dwzg/probe-wink/enclosure/models/housing-lid.step

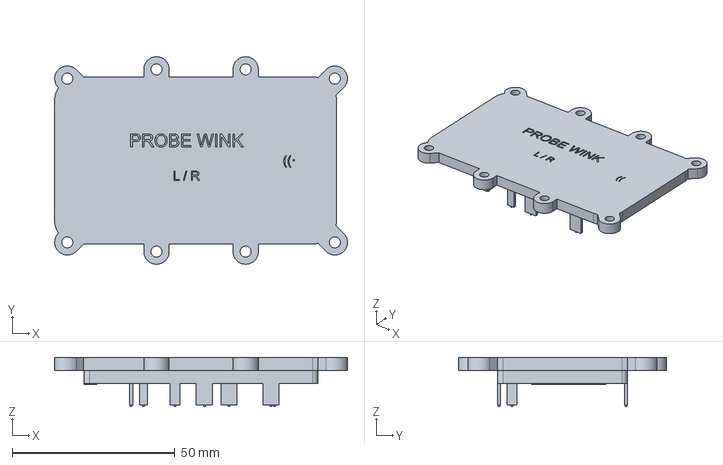
[picture p3: CAD file, 2026-11-01]
enclosure/models/housing-lid.step
90.0 x 63.8 x 15.2 mm
