dwzg/probe-wink/enclosure/models/housing-base.step

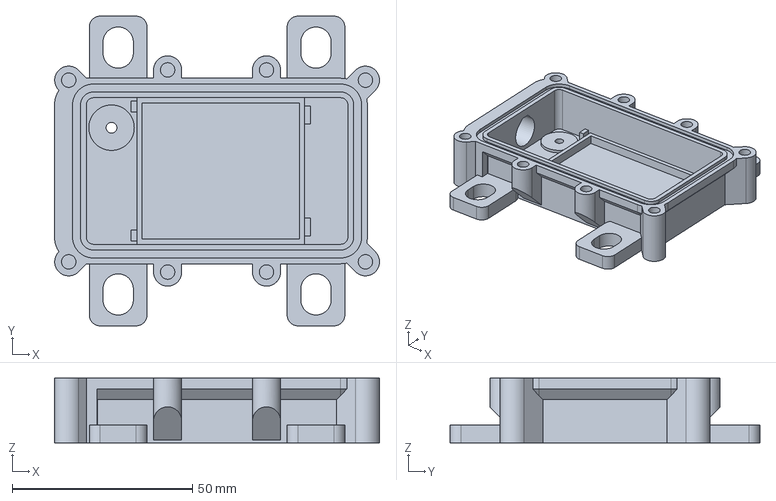
[picture p4: CAD file, 2026-11-01]
enclosure/models/housing-base.step
90.0 x 85.8 x 18.0 mm
