dwzg/probe-wink/(list of files, cad)

Other CAD files:
enclosure/models/housing-base.stl
enclosure/models/housing-lid.stl
