dwzg/probe-wink/pcb/probe-wink.kicad_pcb

## KiCad design pcb/probe-wink.kicad_pcb (2026-11-01)

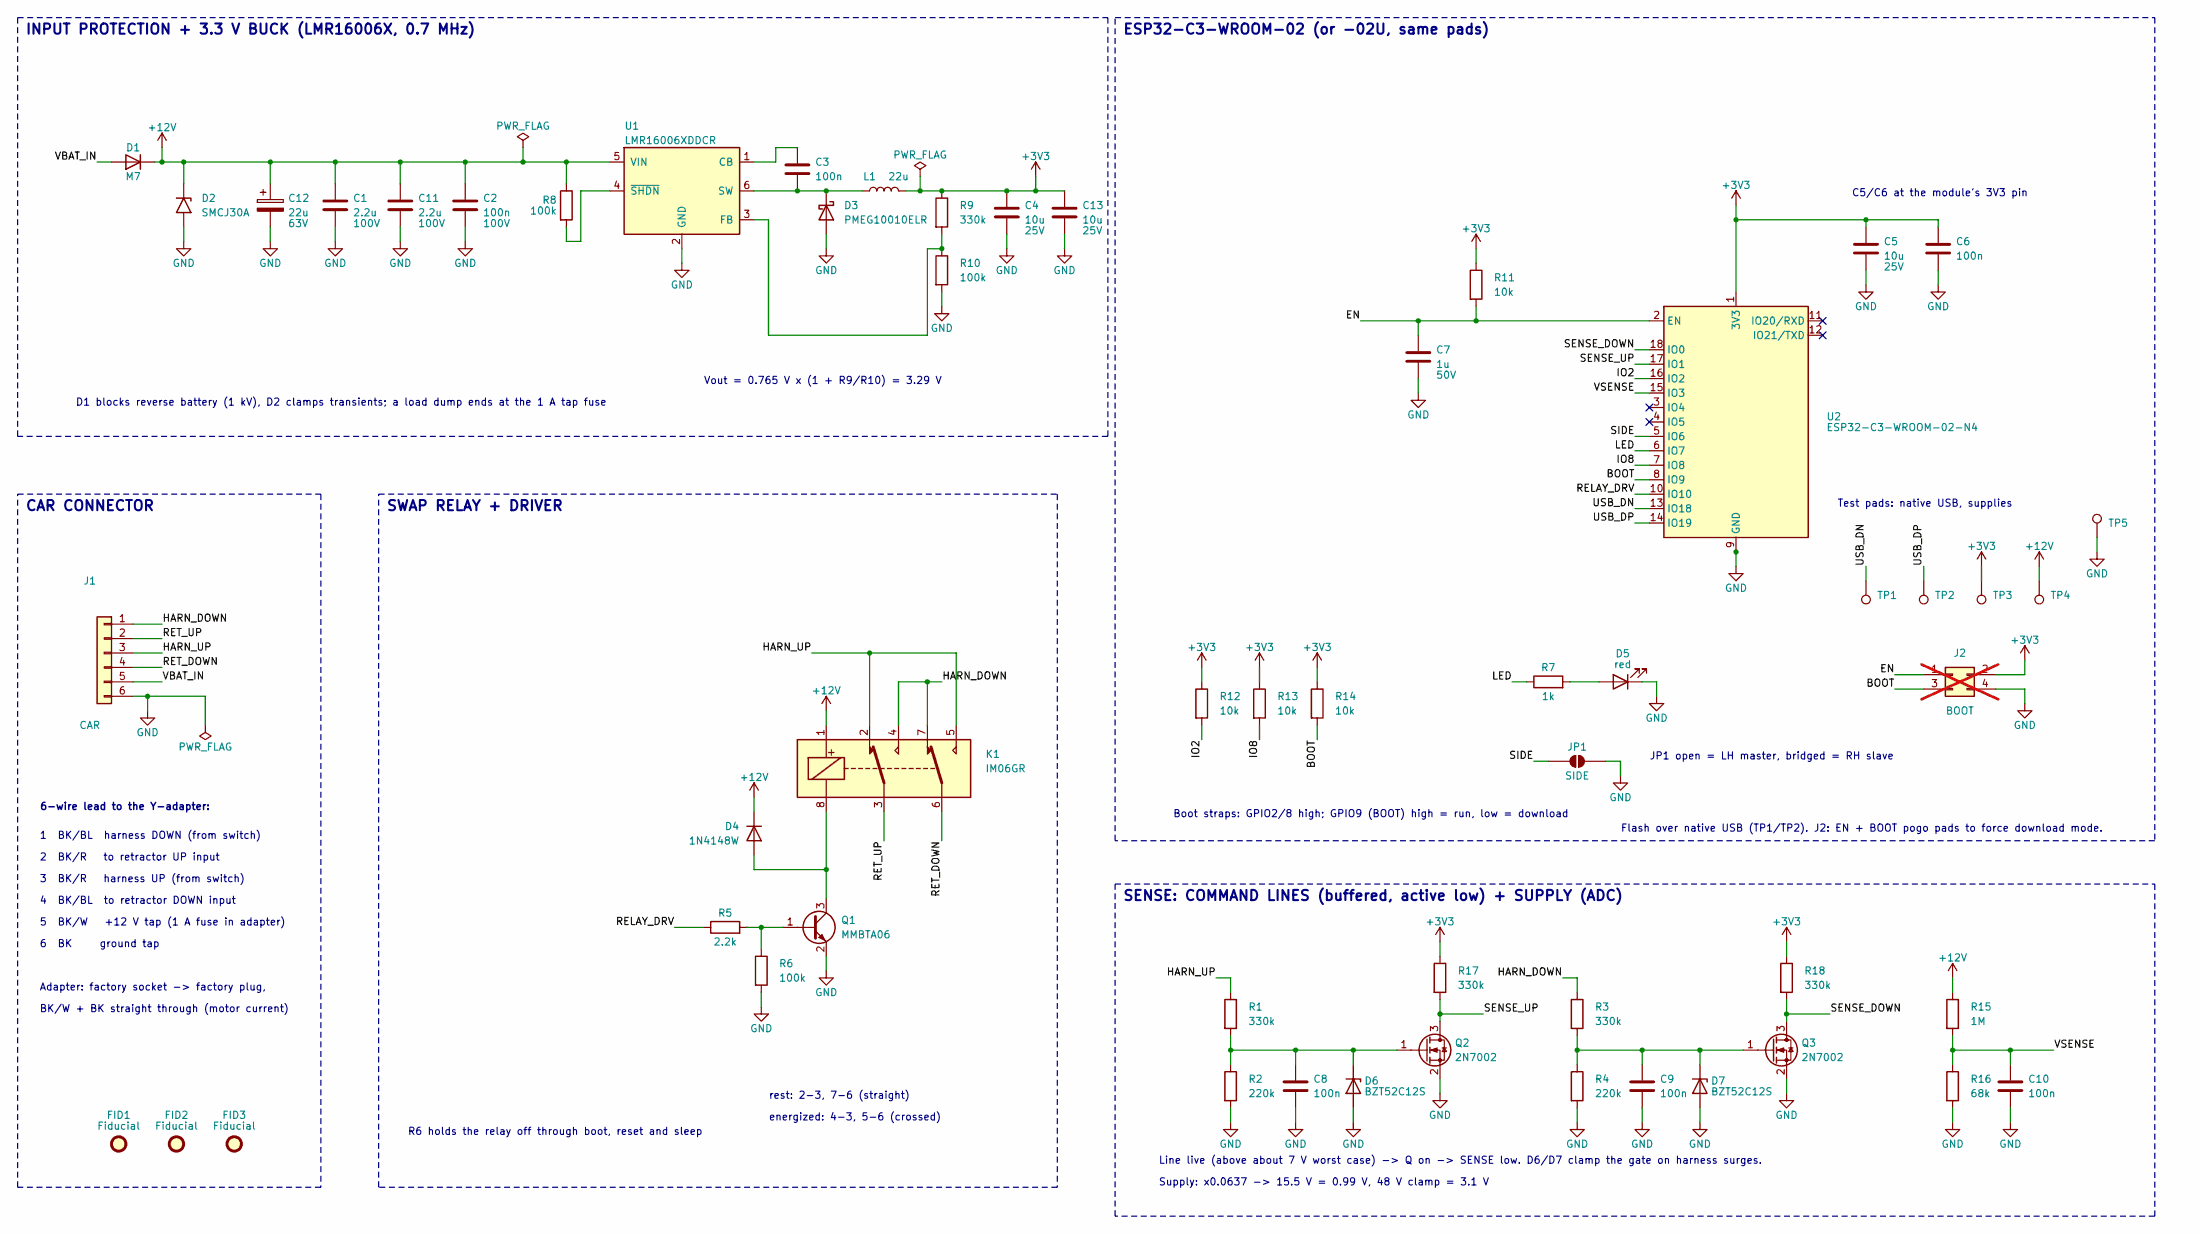
[picture p6: schematic probe-wink.kicad_sch, Probe wink module]

Parts:
C1, C11: 2.2u; C_1206_3216Metric; Rating 100V; MPN CC1206KKX7R0BB225; LCSC C577211
C2: 100n; C_0805_2012Metric; Rating 100V; MPN CL21B104KCFNNNE; LCSC C28233
C3, C6, C8, C9, C10: 100n; C_0805_2012Metric; MPN CC0805KRX7R9BB104; LCSC C49678
C4, C5, C13: 10u; C_0805_2012Metric; Rating 25V; MPN CL21B106KAYQNNE; LCSC C3039694
C7: 1u; C_0805_2012Metric; Rating 50V; MPN CL21B105KBFNNNE; LCSC C28323
C12: 22u; CP_Elec_6.3x5.4; Rating 63V; MPN RVT63V22M6X5; LCSC C51018397
D1: M7; D_SMA; MPN M7; LCSC C95872
D2: SMCJ30A; D_SMC; MPN SMCJ30A (Littelfuse); LCSC C224048
D3: PMEG10010ELR; Nexperia_CFP3_SOD-123W; MPN PMEG10010ELRX; LCSC C179426
D4: 1N4148W; D_SOD-123; MPN 1N4148W; LCSC C81598
D5: red; LED_0805_2012Metric; MPN NCD0805R1; LCSC C84256
D6, D7: BZT52C12S; D_SOD-323; MPN BZT52C12S; LCSC C14643
FID1, FID2, FID3: Fiducial; Fiducial_1mm_Mask2mm
J1: CAR; SolderWire-0.5sqmm_1x06_P4.8mm_D0.9mm_OD2.3mm; MPN sheathed 6 x 0.5 mm2 lead (LiYY 6x0.5)
J2: BOOT; PogoPads_2x02_P2.54mm; MPN bare pads on the back behind the module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; not fitted
JP1: SIDE; SolderJumper-2_P1.3mm_Open_RoundedPad1.0x1.5mm
K1: IM06GR; Relay_2P2T_10x6mm_TE_IMxxG; MPN IM06GR (TE), alt HFD4/12-SR C44212; LCSC C2153106
L1: 22u; L_Sunlord_SWPA5040S; MPN SWPA5040S220MT; LCSC C68434
Q1: MMBTA06; SOT-23; MPN MMBTA06LT1G (80 V NPN); LCSC C77760
Q2, Q3: 2N7002; SOT-23; MPN 2N7002; LCSC C8545
R1, R3, R9, R17, R18: 330k; R_0805_2012Metric; MPN 0805W8F3303T5E; LCSC C17629
R2, R4: 220k; R_0805_2012Metric; MPN 0805W8F2203T5E; LCSC C17556
R5: 2.2k; R_0805_2012Metric; MPN 0805W8F2201T5E; LCSC C17520
R6, R8, R10: 100k; R_0805_2012Metric; MPN 0805W8F1003T5E; LCSC C149504
R7: 1k; R_0805_2012Metric; MPN 0805W8F1001T5E; LCSC C17513
R11, R12, R13, R14: 10k; R_0805_2012Metric; MPN 0805W8F1002T5E; LCSC C17414
R15: 1M; R_0805_2012Metric; MPN 0805W8F1004T5E; LCSC C17514
R16: 68k; R_0805_2012Metric; MPN 0805W8F6802T5E; LCSC C17801
TP1: USB_DN; TestPoint_Pad_D1.5mm
TP2: USB_DP; TestPoint_Pad_D1.5mm
TP3: +3V3; TestPoint_Pad_D1.5mm
TP4: +12V; TestPoint_Pad_D1.5mm
TP5: GND; TestPoint_Pad_D1.5mm
U1: LMR16006XDDCR; TSOT-23-6; MPN LMR16006XDDCR; LCSC C87080
U2: ESP32-C3-WROOM-02-N4; ESP32-C3-WROOM-02; MPN ESP32-C3-WROOM-02-N4; LCSC C2934560

Connections:
+3V3: C4.1, C5.1, C6.1, C13.1, J2.2, L1.2, R9.1, R11.1, R12.1, R13.1, R14.1, R17.1, R18.1, TP3.1, U2.1 (3V3)
+12V: C1.1, C2.1, C11.1, C12.1, D1.1 (K), D2.1 (A1), D4.1 (K), K1.1, R8.1, R15.1, TP4.1, U1.5 (VIN)
/BOOT: J2.3, R14.2, U2.8 (IO9)
/EN: C7.1, J2.1, R11.2, U2.2 (EN)
/HARN_DOWN: J1.1, K1.4, K1.7, R3.1
/HARN_UP: J1.3, K1.2, K1.5, R1.1
/IO2: R12.2, U2.16 (IO2)
/IO8: R13.2, U2.7 (IO8)
/LED: R7.1, U2.6 (IO7)
/RELAY_DRV: R5.1, U2.10 (IO10)
/RET_DOWN: J1.4, K1.6
/RET_UP: J1.2, K1.3
/SENSE_DOWN: Q3.3 (D), R18.2, U2.18 (IO0)
/SENSE_UP: Q2.3 (D), R17.2, U2.17 (IO1)
/SIDE: JP1.1 (A), U2.5 (IO6)
/USB_DN: TP1.1, U2.13 (IO18)
/USB_DP: TP2.1, U2.14 (IO19)
/VBAT_IN: D1.2 (A), J1.5
/VSENSE: C10.1, R15.2, R16.1, U2.15 (IO3)
GND: C1.2, C2.2, C4.2, C5.2, C6.2, C7.2, C8.2, C9.2, C10.2, C11.2, C12.2, C13.2, D2.2 (A2), D3.2 (A), D5.1 (K), D6.2 (A), D7.2 (A), J1.6, J2.4, JP1.2 (B), Q1.2 (E), Q2.2 (S), Q3.2 (S), R2.2, R4.2, R6.2, R10.2, R16.2, TP5.1, U1.2 (GND), U2.9 (GND), U2.19 (GND)
unnamed: C3.2, D3.1 (K), L1.1, U1.6 (SW)
unnamed: D4.2 (A), K1.8, Q1.3 (C)
unnamed: D5.2 (A), R7.2
unnamed: C8.1, D6.1 (K), Q2.1 (G), R1.2, R2.1
unnamed: C9.1, D7.1 (K), Q3.1 (G), R3.2, R4.1
unnamed: Q1.1 (B), R5.2, R6.1
unnamed: C3.1, U1.1 (CB)
unnamed: R9.2, R10.1, U1.3 (FB)
unnamed: R8.2, U1.4 (~SHDN)

Notes on the sheet:
INPUT PROTECTION + 3.3 V BUCK (LMR16006X, 0.7 MHz)
Vout = 0.765 V x (1 + R9/R10) = 3.29 V
D1 blocks reverse battery (1 kV), D2 clamps transients; a load dump ends at the 1 A tap fuse
CAR CONNECTOR
6-wire lead to the Y-adapter:
1 BK/BL harness DOWN (from switch)
2 BK/R to retractor UP input
3 BK/R harness UP (from switch)
4 BK/BL to retractor DOWN input
5 BK/W +12 V tap (1 A fuse in adapter)
6 BK ground tap
Adapter: factory socket -> factory plug,
BK/W + BK straight through (motor current)
SWAP RELAY + DRIVER
rest: 2-3, 7-6 (straight)
energized: 4-3, 5-6 (crossed)
R6 holds the relay off through boot, reset and sleep
ESP32-C3-WROOM-02 (or -02U, same pads)
C5/C6 at the module's 3V3 pin
Boot straps: GPIO2/8 high; GPIO9 (BOOT) high = run, low = download
JP1 open = LH master, bridged = RH slave
Test pads: native USB, supplies
Flash over native USB (TP1/TP2). J2: EN + BOOT pogo pads to force download mode.
SENSE: COMMAND LINES (buffered, active low) + SUPPLY (ADC)
Line live (above about 7 V worst case) -> Q on -> SENSE low. D6/D7 clamp the gate on harness surges.
Supply: x0.0637 -> 15.5 V = 0.99 V, 48 V clamp = 3.1 V

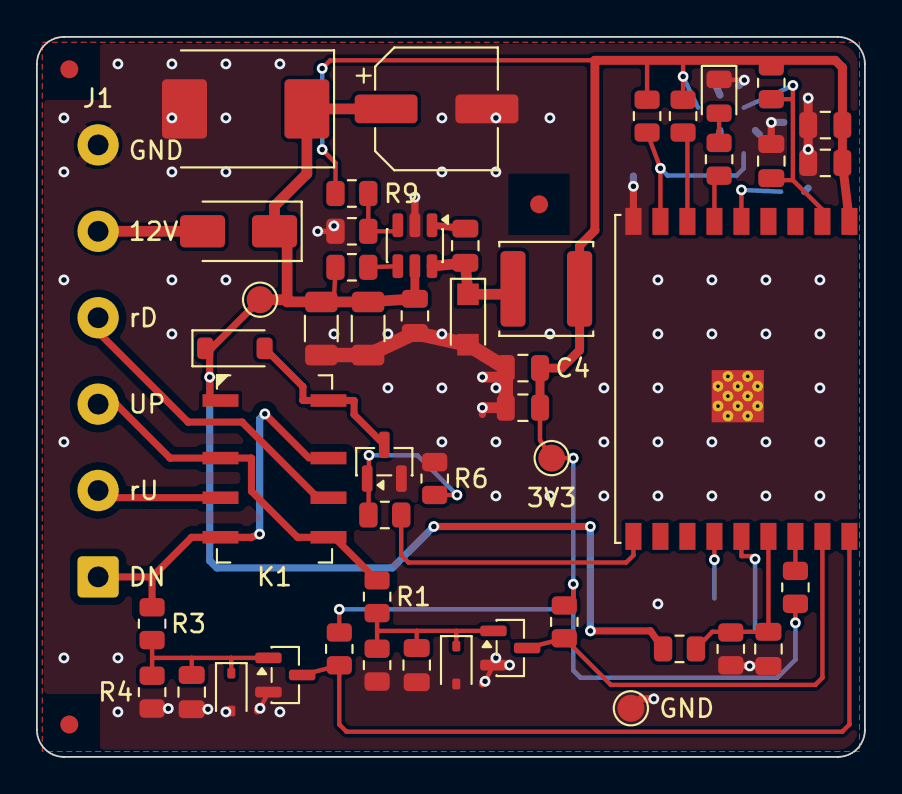
[picture p7: board probe-wink.kicad_pcb from above]

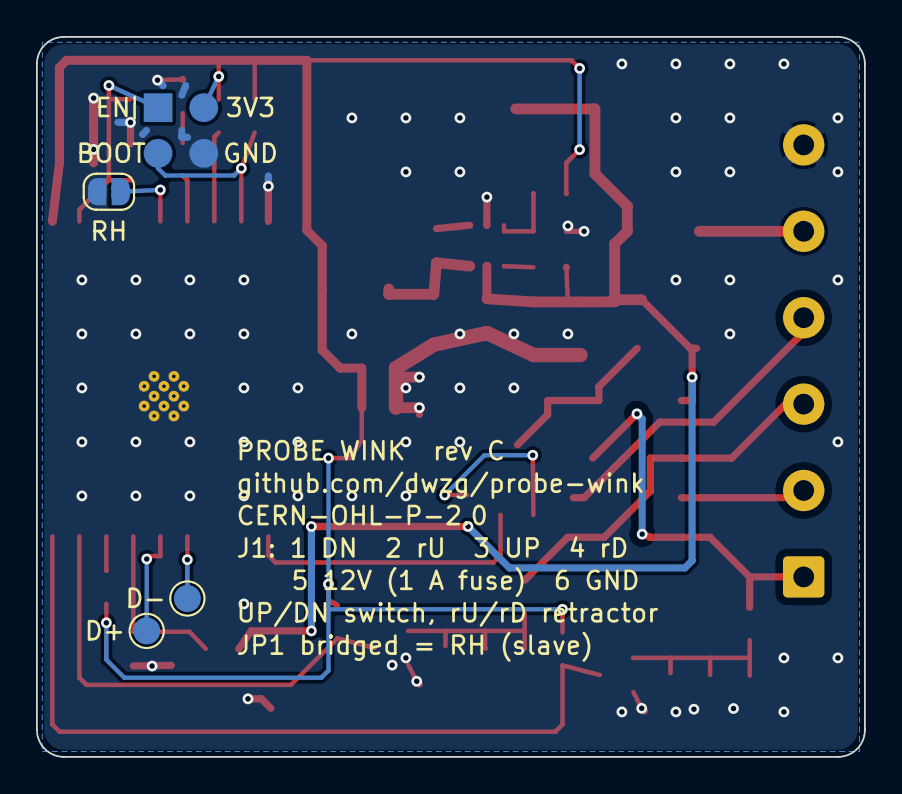
[picture p8: board probe-wink.kicad_pcb from below]

Board: 2 copper layers, 46.0 x 40.0 mm, 56 parts (4 on the bottom side), 29 nets.
