dwzg/probe-wink/pcb/schematic.py

#!/usr/bin/env python3
"""Probe wink module: schematic source.

Run:  python3 schematic.py   -> probe-wink.kicad_sch, intended_netlist.json, lib tables
The .kicad_sch is generated; edit this file, not the schematic.

Every part declares its nets; the drawing below realizes them with wires,
power symbols and labels. check.py proves KiCad sees the same nets.
"""
import json
import os
import sys

HERE = os.path.dirname(os.path.abspath(__file__))
sys.path.insert(0, os.path.join(HERE, "..", "tools", "hw-design", "src"))
from hwdesign.kicad.schematic import Schematic  # noqa: E402

R0805 = "Resistor_SMD:R_0805_2012Metric"
C0805 = "Capacitor_SMD:C_0805_2012Metric"
C1206 = "Capacitor_SMD:C_1206_3216Metric"
HAND = {"Assembly": "hand"}

# JLCPCB/LCSC numbers, verified in stock 2026-11-01. value -> (LCSC, MPN)
PASSIVES = {
    "330k": ("C17629", "0805W8F3303T5E"), "100k": ("C149504", "0805W8F1003T5E"),
    "30k": ("C17621", "0805W8F3002T5E"), "10k": ("C17414", "0805W8F1002T5E"),
    "1k": ("C17513", "0805W8F1001T5E"), "100": ("C17408", "0805W8F1000T5E"),
    "4.7u 50V": ("C29823", "1206B475K500NT"), "100n 50V": ("C49678", "CC0805KRX7R9BB104"),
    "100n": ("C49678", "CC0805KRX7R9BB104"), "22u 25V": ("C45783", "CL21A226MAQNNNE"),
    "10u 25V": ("C3039694", "CL21B106KAYQNNE"), "1u 50V": ("C28323", "CL21B105KBFNNNE"),
    "4.7k": ("C17673", "0805W8F4701T5E"), "2.2k": ("C17520", "0805W8F2201T5E"),
    "100n 100V": ("C28233", "CL21B104KCFNNNE"), "2.2u 100V": ("C577211", "CC1206KKX7R0BB225"),
    "1M": ("C17514", "0805W8F1004T5E"), "68k": ("C17801", "0805W8F6802T5E"),
    "220k": ("C17556", "0805W8F2203T5E"), "499": ("C17722", "0805W8F4990T5E"),
}


def part(lcsc, mpn, **extra):
    return {"Assembly": "SMT", "LCSC": lcsc, "MPN": mpn, **extra}


s = Schematic("probe-wink", title="Probe wink module", rev="C", date="2026-11-01",
              company="wtzg.de",
              comments=["One module per pop-up headlamp, 1989-92 Ford Probe",
                        "Swaps the retractor's UP/DOWN command lines; relay off = stock behavior",
                        "Generated by pcb/schematic.py - do not edit by hand",
                        "CERN-OHL-P-2.0 - source: github.com/dwzg/probe-wink"])

V_TXT = dict(ref_at=(3.05, -1.27), val_at=(3.05, 1.27))                  # vertical 2-pin parts
H_TXT = dict(ref_at=(0, -2.54, "center"), val_at=(0, 2.54, "center"))    # horizontal 2-pin parts


def R(ref, pos, value, a, b, rot=0, **f):
    txt = V_TXT if rot in (0, 180) else H_TXT
    return s.add(ref, "Device:R", pos, value, R0805, {"1": a, "2": b}, rot=rot,
                 fields=part(*PASSIVES[value], **f), **txt)


def C(ref, pos, value, a, b, fp=C0805, rot=0, **f):
    """Capacitor; a value like "2.2u 100V" shows the rating as its own line under the value."""
    txt = V_TXT if rot in (0, 180) else H_TXT
    cap, _, rating = value.partition(" ")
    fields = part(*PASSIVES[value], **f)
    show = None
    if rating:
        fields["Rating"] = rating
        show = ["Rating"]
    return s.add(ref, "Device:C", pos, cap, fp, {"1": a, "2": b}, rot=rot, fields=fields, show=show, **txt)


def gnd(at):
    s.power("GND", at)


# ============================================================ power input + buck
s.frame(20.32, 20.32, 191.77, 73.66, "INPUT PROTECTION + 3.3 V BUCK (LMR16006X, 0.7 MHz)")
s.add("U1", "Regulator_Switching:LMR16006YQ", (137.16, 50.8), "LMR16006XDDCR",
      "Package_TO_SOT_SMD:TSOT-23-6",
      {"1": "BUCK_CB", "2": "GND", "3": "BUCK_FB", "4": "BUCK_EN", "5": "+12V", "6": "BUCK_SW"},
      fields=part("C87080", "LMR16006XDDCR"))
rail = s.pin("U1", 5)[1]                       # +12 V rail runs at VIN height
s.add("D1", "Device:D", (40.64, rail), "M7", "Diode_SMD:D_SMA",
      {"1": "+12V", "2": "VBAT_IN"}, rot=180,
      fields=part("C95872", "M7", Function="reverse polarity, 1 kV"), **H_TXT)
s.tag(("D1", 2))                               # VBAT_IN from the car connector
s.add("D2", "Diode:SM6T24A", (49.53, rail + 7.62), "SMCJ30A", "Diode_SMD:D_SMC",
      {"1": "+12V", "2": "GND"}, rot=270, fields=part("C224048", "SMCJ30A (Littelfuse)"), **V_TXT)
s.add("C12", "Device:C_Polarized", (64.77, rail + 7.62), "22u", "Capacitor_SMD:CP_Elec_6.3x5.4",
      {"1": "+12V", "2": "GND"}, fields=part("C51018397", "RVT63V22M6X5", Function="bulk, damping", Rating="63V"),
      show=["Rating"],
      **V_TXT)
C("C1", (76.2, rail + 7.62), "2.2u 100V", "+12V", "GND", fp=C1206)
C("C11", (87.63, rail + 7.62), "2.2u 100V", "+12V", "GND", fp=C1206)
C("C2", (99.06, rail + 7.62), "100n 100V", "+12V", "GND")
R("R8", (116.84, rail + 7.62), "100k", "+12V", "BUCK_EN")
s.wire(("D1", 1), ("U1", 5))                   # the rail
for ref in ("D2", "C12", "C1", "C11", "C2", "R8"):
    s.wire((ref, 1), (s.pin(ref, 1)[0], rail))
for ref in ("D2", "C12", "C1", "C11", "C2"):
    gnd((ref, 2))
x_en = s.pin("U1", 4)[0] - 5.08
r8b = s.pin("R8", 2)
s.wire(("R8", 2), (r8b[0], r8b[1] + 2.54), (x_en, r8b[1] + 2.54), (x_en, s.pin("U1", 4)[1]), ("U1", 4))
s.power("+12V", (45.72, rail), direction="up")
s.power_flag("+12V", (109.22, rail))
gnd(("U1", 2))
# boot cap, catch diode, inductor along the switch node
cb, sw, fb = s.pin("U1", 1), s.pin("U1", 6), s.pin("U1", 3)
C("C3", (cb[0] + 7.62, sw[1] - 3.81), "100n", "BUCK_CB", "BUCK_SW")
s.wire(("U1", 1), (cb[0] + 3.81, cb[1]), (cb[0] + 3.81, s.pin("C3", 1)[1]), ("C3", 1))
s.add("D3", "Device:D_Schottky", (cb[0] + 12.7, sw[1] + 3.81), "PMEG10010ELR", "Diode_SMD:Nexperia_CFP3_SOD-123W",
      {"1": "BUCK_SW", "2": "GND"}, rot=270,
      fields=part("C179426", "PMEG10010ELRX", Function="catch diode, low leakage hot"), **V_TXT)
s.add("L1", "Device:L", (cb[0] + 22.86, sw[1]), "22u", "Inductor_SMD:L_Sunlord_SWPA5040S",
      {"1": "BUCK_SW", "2": "+3V3"}, rot=90, fields=part("C68434", "SWPA5040S220MT"),
      ref_at=(-2.54, -2.54, "center"), val_at=(2.54, -2.54, "center"))
s.wire(("U1", 6), ("C3", 2))
s.wire(("C3", 2), ("D3", 1))
s.wire(("D3", 1), ("L1", 1))
gnd(("D3", 2))
# output: divider + output cap + 3V3 symbol
xo = s.pin("L1", 2)[0]
R("R9", (xo + 6.35, sw[1] + 3.81), "330k", "+3V3", "BUCK_FB")
R("R10", (xo + 6.35, sw[1] + 13.97), "100k", "BUCK_FB", "GND")
C("C4", (xo + 17.78, sw[1] + 3.81), "10u 25V", "+3V3", "GND")
C("C13", (xo + 27.94, sw[1] + 3.81), "10u 25V", "+3V3", "GND")
s.wire(("L1", 2), ("R9", 1))
s.wire(("R9", 1), ("C4", 1))
s.wire(("C4", 1), ("C13", 1))
s.power("+3V3", (xo + 22.86, sw[1]), direction="up")
s.power_flag("+3V3", (xo + 2.54, sw[1]))
s.wire(("R9", 2), ("R10", 1))
gnd(("R10", 2))
gnd(("C4", 2))
gnd(("C13", 2))
r9b = s.pin("R9", 2)
y_fb = s.pin("R10", 2)[1] + 7.62
s.wire(("U1", 3), (fb[0] + 2.54, fb[1]), (fb[0] + 2.54, y_fb), (xo + 3.81, y_fb),
       (xo + 3.81, r9b[1] + 1.905), (r9b[0], r9b[1] + 1.905))
s.text("Vout = 0.765 V x (1 + R9/R10) = 3.29 V", 140.97, 85.09)
s.text("D1 blocks reverse battery (1 kV), D2 clamps transients; a load dump ends at the 1 A tap fuse", 30.48, 88.9)

# ============================================================ car connector
s.frame(20.32, 104.14, 53.34, 121.92, "CAR CONNECTOR")
s.add("J1", "Connector_Generic:Conn_01x06", (35.56, 132.08), "CAR",
      "Connector_Wire:SolderWire-0.5sqmm_1x06_P4.8mm_D0.9mm_OD2.3mm",
      {"1": "HARN_DOWN", "2": "RET_UP", "3": "HARN_UP", "4": "RET_DOWN", "5": "VBAT_IN", "6": "GND"},
      mirror=True, fields={**HAND, "MPN": "sheathed 6 x 0.5 mm2 lead (LiYY 6x0.5)"},
      ref_at=(-2.54, -12.7, "center"), val_at=(-2.54, 12.7, "center"))
for n in (1, 2, 3, 4, 5):
    s.tag(("J1", n), length=5.08)
j6 = s.pin("J1", 6)
s.wire(("J1", 6), (j6[0] + 2.54, j6[1]))
s.power("GND", (j6[0] + 2.54, j6[1]), direction="down")
s.wire((j6[0] + 2.54, j6[1]), (j6[0] + 12.7, j6[1]))
s.power_flag("GND", (j6[0] + 12.7, j6[1]), direction="down", length=5.08)
s.text("6-wire lead to the Y-adapter:", 24.13, 160.02, size=1.27, bold=True)
for i, line in enumerate(["1  BK/BL  harness DOWN (from switch)",
                          "2  BK/R   to retractor UP input",
                          "3  BK/R   harness UP (from switch)",
                          "4  BK/BL  to retractor DOWN input",
                          "5  BK/W   +12 V tap (1 A fuse in adapter)",
                          "6  BK     ground tap"]):
    s.text(line, 24.13, 165.1 + i * 3.81, size=1.27)
s.text("Adapter: factory socket -> factory plug,", 24.13, 191.77, size=1.27)
s.text("BK/W + BK straight through (motor current)", 24.13, 195.58, size=1.27)

# ============================================================ swap relay + driver
s.frame(83.82, 104.14, 119.38, 121.92, "SWAP RELAY + DRIVER")
# TE IM06GR (alt. Hongfa HFD4/12-SR, same footprint): pin numbering as Omron G6K-2
s.add("K1", "Relay:G6K-2", (172.72, 152.4), "IM06GR", "Relay_SMD:Relay_2P2T_10x6mm_TE_IMxxG",
      {"1": "+12V", "8": "COIL_LO", "3": "RET_UP", "2": "HARN_UP", "4": "HARN_DOWN",
       "6": "RET_DOWN", "7": "HARN_DOWN", "5": "HARN_UP"},
      fields=part("C2153106", "IM06GR (TE), alt HFD4/12-SR C44212"),
      ref_at=(17.78, -2.54), val_at=(17.78, 0))
# map to the drawing names used below (G5V-2 numbering of rev A)
_m = {1: 1, 4: 3, 6: 2, 8: 4, 9: 5, 11: 7, 13: 6, 16: 8}
k = {n: s.pin("K1", _m[n]) for n in _m}
y_up, y_dn = k[6][1] - 12.7, k[6][1] - 7.62     # HARN_UP bus above HARN_DOWN bus
s.wire(("K1", 2), (k[6][0], y_up), (k[9][0], y_up), ("K1", 5))
s.wire(("K1", 4), (k[8][0], y_dn), (k[11][0], y_dn), ("K1", 7))
s.wire((k[6][0], y_up), (k[6][0] - 10.16, y_up))
s.tag((k[6][0] - 10.16, y_up), "HARN_UP", length=0, direction="left")
s.wire((k[11][0], y_dn), (k[11][0] + 2.54, y_dn))
s.tag((k[11][0] + 2.54, y_dn), "HARN_DOWN", length=0, direction="right")
s.tag(("K1", 3), length=5.08)
s.tag(("K1", 6), length=5.08)
s.power("+12V", ("K1", 1))
s.text("rest: 2-3, 7-6 (straight)", 152.4, 210.82)
s.text("energized: 4-3, 5-6 (crossed)", 152.4, 214.63)
# driver
s.add("Q1", "Transistor_BJT:MMBTA06", (k[16][0] - 2.54, k[16][1] + 20.32), "MMBTA06",
      "Package_TO_SOT_SMD:SOT-23", {"1": "RELAY_G", "2": "GND", "3": "COIL_LO"},
      fields=part("C77760", "MMBTA06LT1G (80 V NPN)"), ref_at=(5.08, -1.27), val_at=(5.08, 1.27))
s.wire(("K1", 8), ("Q1", 3))
gnd(("Q1", 2))
s.add("D4", "Device:D", (k[16][0] - 12.7, k[16][1] + 3.81), "1N4148W", "Diode_SMD:D_SOD-123",
      {"1": "+12V", "2": "COIL_LO"}, rot=270, fields=part("C81598", "1N4148W", Function="flyback"),
      ref_at=(-2.54, -1.27, "right"), val_at=(-2.54, 1.27, "right"))
s.power("+12V", ("D4", 1))
d4a = s.pin("D4", 2)
s.wire(("D4", 2), (d4a[0], d4a[1] + 2.54), (k[16][0], d4a[1] + 2.54))
g = s.pin("Q1", 1)
R("R5", (g[0] - 10.16, g[1]), "2.2k", "RELAY_DRV", "RELAY_G", rot=90)
s.wire(("R5", 2), ("Q1", 1))
R("R6", (g[0] - 3.81, g[1] + 7.62), "100k", "RELAY_G", "GND")
s.wire(("R6", 1), (g[0] - 3.81, g[1]))
gnd(("R6", 2))
s.tag(("R5", 1), length=5.08)
s.text("R6 holds the relay off through boot, reset and sleep", 88.9, 217.17)

# ============================================================ ESP32-C3
s.frame(213.36, 20.32, 182.88, 144.78, "ESP32-C3-WROOM-02 (or -02U, same pads)")
s.add("U2", "RF_Module:ESP32-C3-WROOM-02", (322.58, 91.44), "ESP32-C3-WROOM-02-N4",
      "RF_Module:ESP32-C3-WROOM-02",
      {"1": "+3V3", "2": "EN", "9": "GND", "19": "GND",
       "18": "SENSE_DOWN", "17": "SENSE_UP", "16": "IO2", "15": "VSENSE",
       "3": None, "4": None, "5": "SIDE", "6": "LED", "7": "IO8", "8": "BOOT",
       "10": "RELAY_DRV", "13": "USB_DN", "14": "USB_DP", "11": None, "12": None},
      fields=part("C2934560", "ESP32-C3-WROOM-02-N4"))
v3 = s.pin("U2", 1)
y3 = v3[1] - 12.7
C("C5", (v3[0] + 22.86, y3 + 5.08), "10u 25V", "+3V3", "GND")
C("C6", (v3[0] + 35.56, y3 + 5.08), "100n", "+3V3", "GND")
s.wire(("U2", 1), (v3[0], y3), (s.pin("C6", 1)[0], y3))
s.wire(("C5", 1), (s.pin("C5", 1)[0], y3))
s.wire(("C6", 1), (s.pin("C6", 1)[0], y3))
s.power("+3V3", (v3[0], y3), direction="up")
gnd(("C5", 2))
gnd(("C6", 2))
s.text("C5/C6 at the module's 3V3 pin", v3[0] + 20.32, y3 - 3.81)
gnd(("U2", 9))
s.drawn.add(("U2", "19"))   # second GND pin shares the symbol position with pin 9
# EN: pull-up, RC delay, reset button
en = s.pin("U2", 2)
xs = [en[0] - 30.48, en[0] - 40.64, en[0] - 50.8]   # R11, C7, SW2 columns
R("R11", (xs[0], en[1] - 6.35), "10k", "+3V3", "EN")
C("C7", (xs[1], en[1] + 6.35), "1u 50V", "EN", "GND")
s.wire(("U2", 2), (xs[2], en[1]))
s.wire(("R11", 2), (xs[0], en[1]))
s.wire(("C7", 1), (xs[1], en[1]))
s.tag((xs[2], en[1]), "EN", length=0, direction="left")
s.power("+3V3", ("R11", 1))
gnd(("C7", 2))
for n in (18, 17, 16, 15, 10, 5, 6, 7, 8, 13, 14):
    s.tag(("U2", n), length=2.54)
# strapping pins + boot button
y_s = 140.97
for i, (ref, net) in enumerate((("R12", "IO2"), ("R13", "IO8"), ("R14", "BOOT"))):
    x = 228.6 + i * 10.16
    R(ref, (x, y_s), "10k", "+3V3", net)
    s.power("+3V3", (ref, 1))
    s.tag((ref, 2), length=2.54)
s.text("Boot straps: GPIO2/8 high; GPIO9 (BOOT) high = run, low = download", 223.52, 161.29)
# LED + side jumper
R("R7", (289.56, y_s - 3.81), "1k", "LED", "LED_A", rot=90)
s.tag(("R7", 1), length=2.54)
s.add("D5", "Device:LED", (302.26, y_s - 3.81), "red", "LED_SMD:LED_0805_2012Metric",
      {"1": "GND", "2": "LED_A"}, rot=180, fields=part("C84256", "NCD0805R1"), **H_TXT)
s.wire(("R7", 2), ("D5", 2))
dk = s.pin("D5", 1)
s.wire(("D5", 1), (dk[0] + 2.54, dk[1]))
s.power("GND", (dk[0] + 2.54, dk[1]), direction="down")
s.add("JP1", "Jumper:SolderJumper_2_Open", (294.64, y_s + 10.16), "SIDE",
      "Jumper:SolderJumper-2_P1.3mm_Open_RoundedPad1.0x1.5mm",
      {"1": "SIDE", "2": "GND"}, fields={"Assembly": "none"}, **H_TXT)
s.tag(("JP1", 1), length=2.54)
jb = s.pin("JP1", 2)
s.wire(("JP1", 2), (jb[0] + 2.54, jb[1]))
s.power("GND", (jb[0] + 2.54, jb[1]), direction="down")
s.text("JP1 open = LH master, bridged = RH slave", 307.34, 151.13)
# programming header (ESP-Prog pinout) + test pads
s.add("J2", "Connector_Generic:Conn_02x02_Odd_Even", (360.68, 135.89), "BOOT",
      "probe-wink:PogoPads_2x02_P2.54mm",
      {"1": "EN", "2": "+3V3", "3": "BOOT", "4": "GND"},
      fields={"Assembly": "none", "MPN": "bare pads on the back behind the module: pogo clip"}, dnp=True,
      ref_at=(1.27, -3.81, "center"), val_at=(1.27, 6.35, "center"))
for n in (1, 3):
    s.tag(("J2", n), length=5.08)
j2p2, j2p4 = s.pin("J2", 2), s.pin("J2", 4)
s.wire(("J2", 2), (j2p2[0] + 5.08, j2p2[1]))
s.power("+3V3", (j2p2[0] + 5.08, j2p2[1]), direction="up")
s.wire(("J2", 4), (j2p4[0] + 5.08, j2p4[1]))
s.power("GND", (j2p4[0] + 5.08, j2p4[1]), direction="down")
for i, (ref, net) in enumerate((("TP1", "USB_DN"), ("TP2", "USB_DP"), ("TP3", "+3V3"), ("TP4", "+12V"))):
    x = 345.44 + i * 10.16
    s.add(ref, "Connector:TestPoint", (x, 119.38), net, "TestPoint:TestPoint_Pad_D1.5mm",
          {"1": net}, rot=180, fields={"Assembly": "none"}, in_bom=False,
          ref_at=(1.9, 2.54), val_at=(1.27, 6.35), hide_value=True)
    if net.startswith("+"):
        s.power(net, (ref, 1))
    else:
        s.tag((ref, 1), length=2.54)
s.add("TP5", "Connector:TestPoint", (386.08, 111.76), "GND", "TestPoint:TestPoint_Pad_D1.5mm",
      {"1": "GND"}, fields={"Assembly": "none"}, in_bom=False, ref_at=(1.9, -2.54), val_at=(1.27, 6.35),
      hide_value=True)
s.power("GND", ("TP5", 1))
s.text("Test pads: native USB, supplies", 340.36, 106.68)
s.text("Flash over native USB (TP1/TP2). J2: EN + BOOT pogo pads to force download mode.", 302.26, 163.83)

# ============================================================ sense buffers + supply divider
s.frame(213.36, 172.72, 182.88, 58.42, "SENSE: COMMAND LINES (buffered, active low) + SUPPLY (ADC)")
for (rt, rb, cc, dz, q, rp, line, g, out, x0) in (
        ("R1", "R2", "C8", "D6", "Q2", "R17", "HARN_UP", "UP_G", "SENSE_UP", 233.68),
        ("R3", "R4", "C9", "D7", "Q3", "R18", "HARN_DOWN", "DN_G", "SENSE_DOWN", 294.64)):
    R(rt, (x0, 195.58), "330k", line, g)
    R(rb, (x0, 208.28), "220k", g, "GND")
    C(cc, (x0 + 11.43, 208.28), "100n", g, "GND")
    s.add(dz, "Device:D_Zener", (x0 + 21.59, 208.28), "BZT52C12S", "Diode_SMD:D_SOD-323",
          {"1": g, "2": "GND"}, rot=270, fields=part("C14643", "BZT52C12S"), **V_TXT)
    s.add(q, "Transistor_FET:2N7002", (x0 + 34.29, 201.93), "2N7002", "Package_TO_SOT_SMD:SOT-23",
          {"1": g, "2": "GND", "3": out}, fields=part("C8545", "2N7002"), ref_at=(5.08, -1.27), val_at=(5.08, 1.27))
    R(rp, (x0 + 36.83, 189.23), "330k", "+3V3", out)
    node = (x0, 201.93)
    s.wire((rt, 2), node, (rb, 1))
    s.wire(node, (x0 + 11.43, node[1]), (x0 + 21.59, node[1]), (q, 1))
    s.wire((x0 + 11.43, node[1]), (cc, 1))
    s.wire((x0 + 21.59, node[1]), (dz, 1))
    s.wire((q, 3), (rp, 2))
    s.wire((x0 + 36.83, 195.58), (x0 + 44.45, 195.58))
    s.tag((x0 + 44.45, 195.58), out, length=0, direction="right")
    rt1 = s.pin(rt, 1)
    s.wire((rt, 1), (rt1[0], rt1[1] - 2.54), (rt1[0] - 2.54, rt1[1] - 2.54))
    s.tag((rt1[0] - 2.54, rt1[1] - 2.54), line, length=0, direction="left")
    s.power("+3V3", (rp, 1))
    for ref, pin in ((rb, 2), (cc, 2), (dz, 2), (q, 2)):
        gnd((ref, pin))
x0 = 360.68
R("R15", (x0, 195.58), "1M", "+12V", "VSENSE")
R("R16", (x0, 208.28), "68k", "VSENSE", "GND")
C("C10", (x0 + 10.16, 208.28), "100n", "VSENSE", "GND")
node = (x0, 201.93)
s.wire(("R15", 2), node, ("R16", 1))
s.wire(node, (x0 + 10.16, node[1]), ("C10", 1))
s.wire((x0 + 10.16, node[1]), (x0 + 17.78, node[1]))
s.tag((x0 + 17.78, node[1]), "VSENSE", length=0, direction="right")
s.power("+12V", ("R15", 1))
gnd(("R16", 2))
gnd(("C10", 2))
s.text("Line live (above about 7 V worst case) -> Q on -> SENSE low. D6/D7 clamp the gate on harness surges.", 220.98, 222.25)
s.text("Supply: x0.0637 -> 15.5 V = 0.99 V, 48 V clamp = 3.1 V", 220.98, 226.06)

# ============================================================ mechanical
for i in range(3):
    s.add("FID%d" % (i + 1), "Mechanical:Fiducial", (38.1 + i * 10.16, 218.44), "Fiducial",
          "Fiducial:Fiducial_1mm_Mask2mm", fields={"Assembly": "none"}, in_bom=False)

s.finish()
out = os.path.join(HERE, "probe-wink.kicad_sch")
s.save(out)
s.write_lib_tables(HERE)
pro = os.path.join(HERE, "probe-wink.kicad_pro")
if not os.path.exists(pro):
    with open(pro, "w") as f:
        json.dump({"meta": {"filename": "probe-wink.kicad_pro", "version": 1}}, f)
with open(os.path.join(HERE, "intended_netlist.json"), "w") as f:
    json.dump(s.netlist(), f, indent=1, sort_keys=True)
for w in s.warnings:
    print("WARN", w)
print("wrote", out, "parts:", len([r for r in s.parts if not r.startswith("#")]), "nets:", len(s.netlist()))
