dwzg/probe-wink/(commit log)

2026-11-01 tools/kicad: generate KiCad schematics and boards from Python
    S-expression reader/writer, schematic builder with an overlap check,
    board builder (placement, locked hand routes, keep-outs, parallel
    Freerouting with a result cache, pours, stitching, dangling-item cleanup,
    copper path-length and hot-loop checks), JLCPCB fab export and board
    geometry export for enclosures.
    Claude-Session: https://claude.ai/code/session_012TbjXXtkPEiUhGgrUDciXp
2026-11-01 pcb: rev C module board
    ESP32-C3-WROOM-02, TE IM06GR swap relay with NPN driver, LMR16006X buck,
    buffered command-line sensing, supply sense. 46 x 40 mm, two layers,
    JLCPCB assembly top side only. Generated by schematic.py and board.py;
    ERC/DRC clean, 18 layout checks pass.
    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
    [probe-wink.kicad_pcb, probe-wink.kicad_sch]
2026-11-01 enclosure: 3D-printable sealed housing
    build123d, ASA/ABS. M12 gland for a 6 x 0.5 mm2 lead, silicone cord seal,
    8 screws in heat-set inserts, board held by edge fingers. check.py measures
    fit, seal, screws and printability on the model (49 checks).
    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
2026-11-01 firmware: Rust on ESP-IDF for the module
    LH master / RH slave over authenticated ESP-NOW, BLE GATT for the phone,
    BLE HID remote, supply guard with a temperature-scaled relay limit, deep
    sleep with wake on the command lines. Also builds for an ESP32 DEVKITV1
    test bench (scripts/devkit).
    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
    [partitions.csv]
2026-11-01 Licence the hardware design under CERN-OHL-P-2.0
    KiCad files in pcb/ and the housing models. The licence identifier and the
    source location are on the back silkscreen and in the schematic title block.
    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
    [probe-wink.kicad_pcb, probe-wink.kicad_sch]
2026-11-01 Add an optional drive lock
    With DRIVELOCK ON (stored on the module, off by default) the LH module
    refuses winks and alternate from the phone and the remote while the
    supply shows the alternator charging (rail >= 12.7 V). STOP always works.
    STATUS reports the setting; the Android app has a switch for it.
    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
2026-11-01 Couple the modules from the app; redesign the Android app
    Firmware: the ESP-NOW link key is no longer built in. The phone writes the
    same random 256-bit key to both modules through a new write-only key
    characteristic (bonded, authenticated link only); the module stores it in
    NVS, resets the replay counters and restarts. Without a key the radio link
    stays silent and the LH module refuses commands that need the RH module.
    The RH module now runs the BLE service too (status and uncouple only).
    Modules advertise as PWink-L / PWink-R. STATUS reports side, coupling with
    a key fingerprint, and whether the RH module was heard. Only the BLE
    passkey remains a build-time secret.
    App: control screen wit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
2026-11-01 pcb: clean up routing after review; docs for app coupling
    - Swap J1 pins 2 and 3 (RET_UP / HARN_UP) so the lead matches the relay's
    pin order; removes a forced crossing left of the relay.
    - Straight hand routes for EN, BOOT and the relay drive; R5 turned so its
    input faces the drive trace.
    - 3V3 for the bottom pull-ups through a via at TP3, and a keep-out that
    stops a long bottom-layer slit left of the buck.
    - tools/kicad: straighten() merges autorouter micro-jogs where the straight
    segment keeps clearance and still covers pads, vias and T-junctions
    (27 merged on this board).
    - Docs: the link key is set by the app's coupling, not at build time; new
    lead pinout.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
    [probe-wink.kicad_pcb, probe-wink.kicad_sch]
2026-11-01 pcb: second routing review; uncross the sense lines
    - Sense lines: SENSE_UP moves to module pin 17 (GPIO1), SENSE_DOWN to pin 18
    (GPIO0), so the line to the far cell starts at the outer pin and the two
    no longer cross. Both drop straight down; firmware pin map swapped.
    - Parts under pins 15-18 rearranged (R12 upright under pin 16, divider row
    left of pin 15) so the sense lines no longer squeeze past them.
    - FB divider: R9 on top, its 3V3 end straight at the riser via; R10's ground
    through its own via into the plane. EN leaves pin 2 at 45 degrees (C6
    0.6 mm higher). Relay drive drops clear of the pad row. 3V3 rail starts
    with one 45-degree step from its via.
    - Hand routes: J1 to t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
    [probe-wink.kicad_pcb, probe-wink.kicad_sch]
2026-11-01 pcb: straight relay coil supply; hand-route RET_DOWN and the divider feed
    - D4 cathode straight down into the coil pin K1.1, rail to D4 at 45 degrees
    (was a hook off the diode's pad corner).
    - Supply-sense feed to R15 hand-routed from a via between D4 and K1.1:
    straight runs, the same layer changes the autorouter needed.
    - RET_DOWN: one 45-degree run from J1 and under the relay, parallel to
    HARN_UP's crossover (the autorouter had sent it to the back through a
    stub and via next to J1).
    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
    [probe-wink.kicad_pcb]
2026-11-01 fab: JLC rotation corrections for SOT-23, TSOT-23-6 and the relay
    Found in JLC's placement preview: their SOT-23 (Q1-Q3) and TSOT-23-6 (U1)
    models have pin 1 opposite KiCad's, and their IM06 relay model lies 90
    degrees across the pad columns.
    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
    [fab.py]
2026-11-01 Use the hw-design library as a submodule instead of tools/kicad
    The KiCad generator library and the generic housing helpers now live in
    github.com/dwzg/hw-design (with Claude Code skills for the workflow),
    pinned at tools/hw-design. pcb/check.py uses its ERC + parity helper;
    enclosure/check.py and render.py import the probing, gasket, print and
    render helpers instead of carrying copies (lid_fe stays here).
    Outputs are unchanged: tracks, vias, placements, zone fill, BOM, CPL,
    netlist and housing STLs identical; Gerbers differ only in drawing order.
    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
    [probe-wink.kicad_pcb, probe-wink.kicad_sch]
2026-11-01 enclosure: keep the current base and lid STEP/STL in enclosure/models
    housing.py now writes the base and lid STEP/STL to the committed
    enclosure/models/ as well as build/, so the current files can be
    printed without KiCad and build123d. The STEP header time is fixed,
    so an unchanged rerun leaves git clean. The M16 variant writes
    *-m16.* next to them. .gitattributes stores the models byte-exact.
    [housing-base.step, housing-base.stl, housing-lid.step, housing-lid.stl]
2026-11-01 docs: add a PCB render next to the housing at the top of the README
